Tanay2920003/HomeTank_YT/tanksync_flutter/assets/onboarding.png

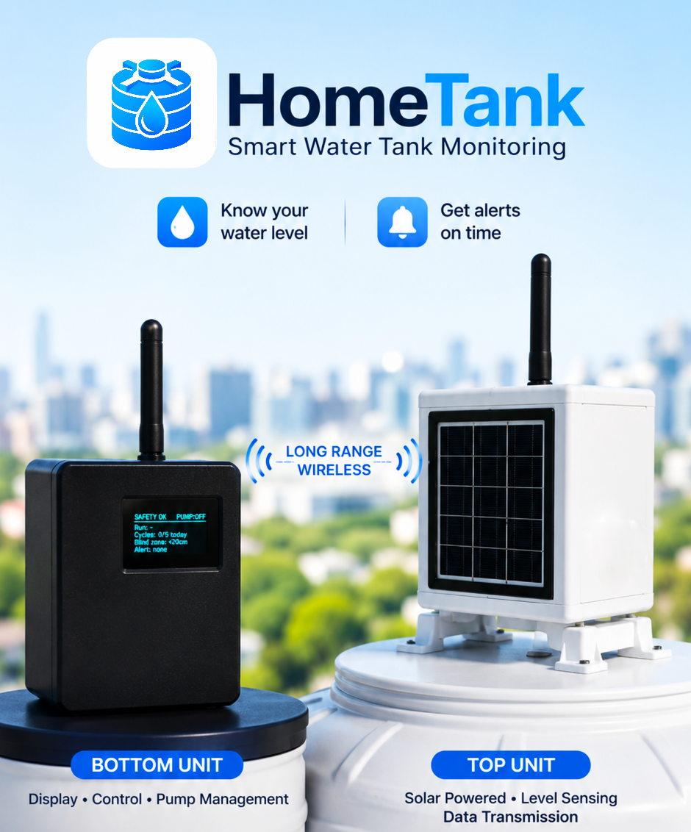
tanksync_flutter/assets/onboarding.png
