Tanay2920003/HomeTank_YT/images/img (2).png

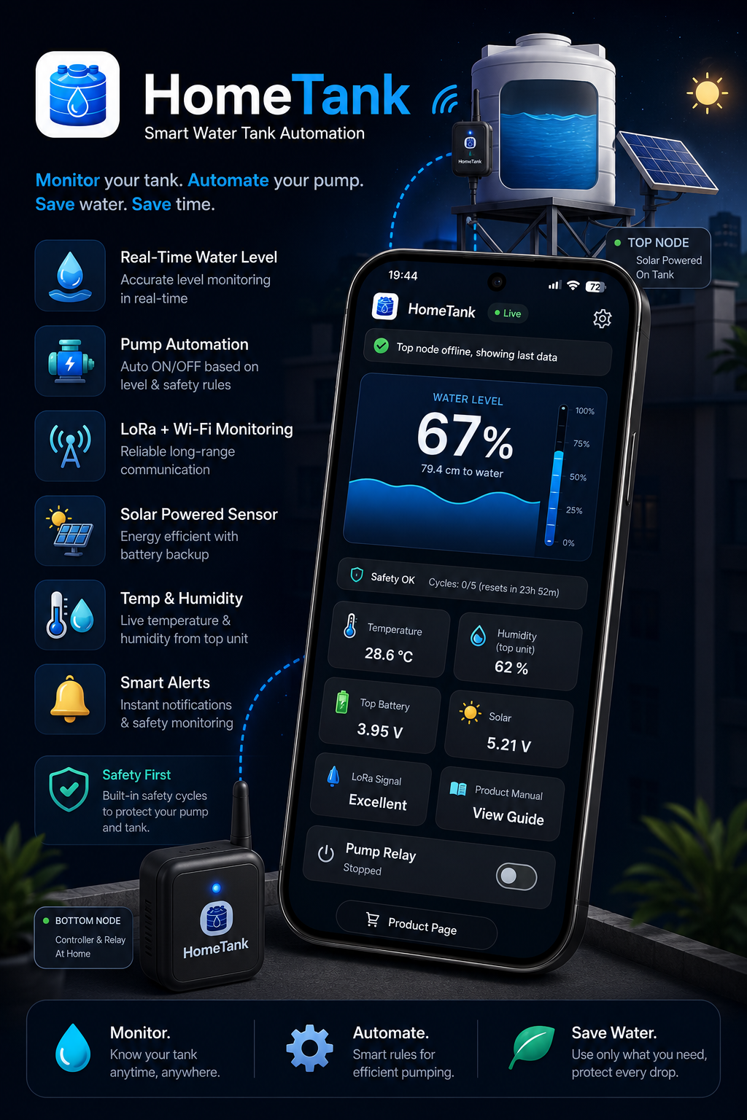
images/img (2).png
