Tanay2920003/HomeTank_YT/README.md

# HomeTank — Dual LoRa Water Tank Automation

Wireless water tank monitor and pump controller built on the **Heltec WiFi LoRa 32 V3** (SX1262).  
Two ESP32 nodes communicate over LoRa: a **Top Node** inside the tank measures water level + temperature, and a **Bottom Node** controls the pump and serves a Flutter companion app over Wi-Fi.

---

## 📸 Hardware

HomeTank top node installed on tank

Concrete roof installation

App screenshot — tank level view

PCB and enclosure

---

## 📱 App UI

<table>
  <tr>
    <td align="center">LoRa radio stats</td>
    <td align="center">Connection mode selector</td>
    <td align="center">Wi-Fi settings</td>
    <td align="center">Tank level dashboard</td>
  </tr>
</table>

---

## 🛠️ Arduino IDE Setup & Installation Guide

### 1. Board Manager Setup (Preferences)
To compile for the Heltec WiFi LoRa 32 V3 board, you must add Heltec's board package to Arduino IDE:

1. Open Arduino IDE and navigate to **File** → **Preferences** (or `Ctrl` + `,` on Windows).
2. In the **Additional Boards Manager URLs** field, paste the following URL:
   ```text
   https://resource.heltec.cn/download/package_heltec_esp32_index.json
   ```
   *(If there are already other URLs, separate them with a comma or new line).*
3. Click **OK**.
4. Navigate to **Tools** → **Board** → **Boards Manager...** (or `Ctrl` + `Shift` + `B`).
5. Search for `Heltec ESP32` and install **Heltec ESP32 Series Dev-boards**.
6. Select your board under **Tools** → **Board** → **Heltec ESP32 Series Dev-boards** → **WiFi LoRa 32(V3) / Wireless_Stick_Lite(V3)** (or **Heltec WiFi LoRa 32 (V3)**).

---

### 2. Required Libraries
Install the following required libraries via **Tools** → **Manage Libraries...** (`Ctrl` + `Shift` + `I`):

| Library Name | Author | Purpose | Used In |
| :--- | :--- | :--- | :--- |
| **RadioLib** | Jan Gromeš | SX1262 LoRa radio communication | Both Top & Bottom |
| **Heltec ESP32 Dev-Boards** | Heltec Automation | OLED Display driver (`HT_SSD1306Wire.h`) | Both Top & Bottom |
| **DHT sensor library** | Adafruit | DHT22 temperature & humidity sensor | Top Node |
| **ArduinoJson** | Benoit Blanchon | JSON serialization for web PWA API | Bottom Node |

> [!TIP]
> When installing **Heltec ESP32 Dev-Boards** or **DHT sensor library**, if Arduino IDE prompts you to install missing dependencies (such as Adafruit Unified Sensor), click **Install All**.

---

### 3. Multi-Unit Production Pairing (Unit ID System)
For production deployments where multiple tank systems operate within LoRa radio range, a hardcoded pairing system prevents RF cross-talk:

- In both `top code/top/final/final/final.ino` and `bottomfinal/sketch_apr1h/final/final/final.ino`, locate the configuration definition:
  ```cpp
  #define UNIT_ID 1001
  ```
- **Important**: Both the Top node and Bottom node for a single tank system **must** share the exact same `UNIT_ID`.
- When manufacturing or installing Unit 2, change `#define UNIT_ID 1002` in both files before flashing. For Unit 3, use `1003`, and so on (supported range: `1` to `65535`).
