Tanay2920003/HomeTank_YT/images/img (1).jpg

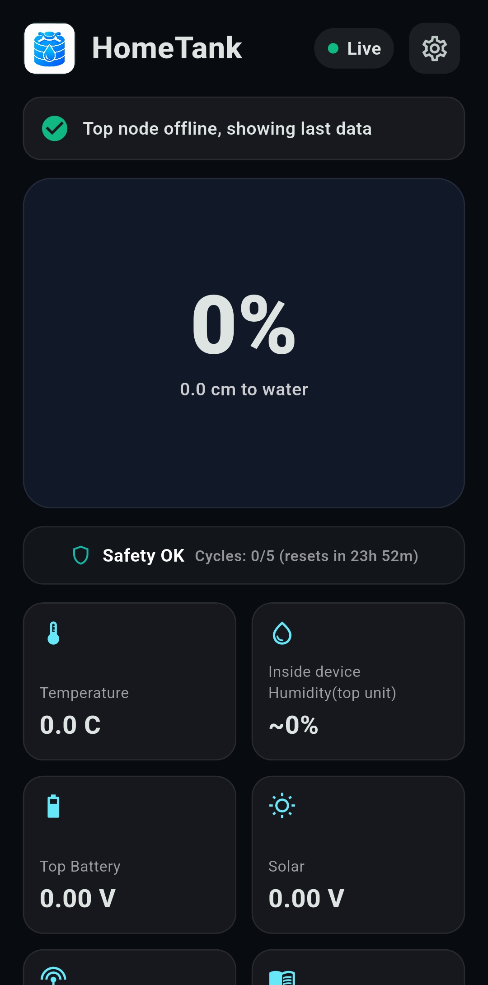
images/img (1).jpg
