Tanay2920003/HomeTank_YT/images/img (1).png

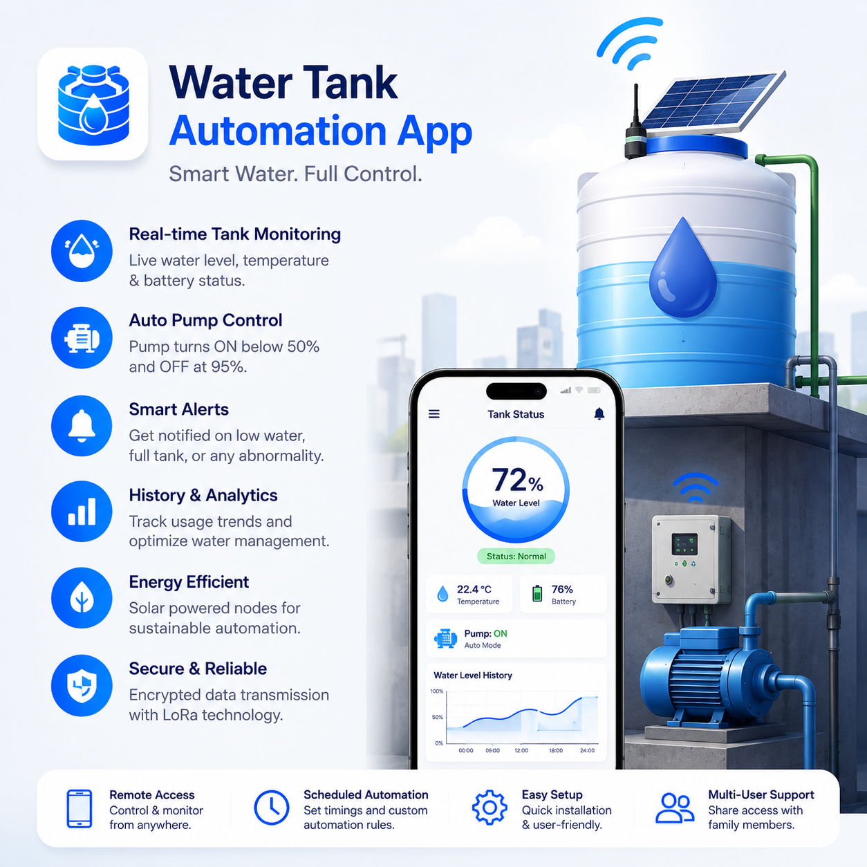
images/img (1).png
