Tanay2920003/HomeTank_YT/images/img (2).jpg

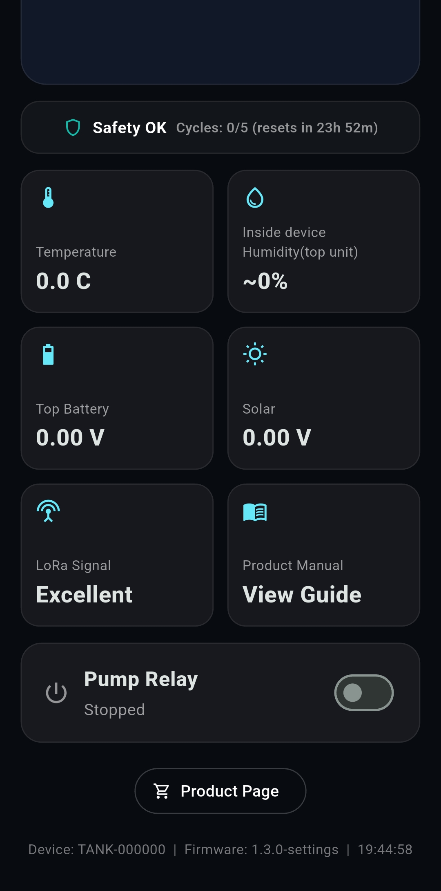
images/img (2).jpg
