Tanay2920003/HomeTank_YT/3D printed/main-body.stl

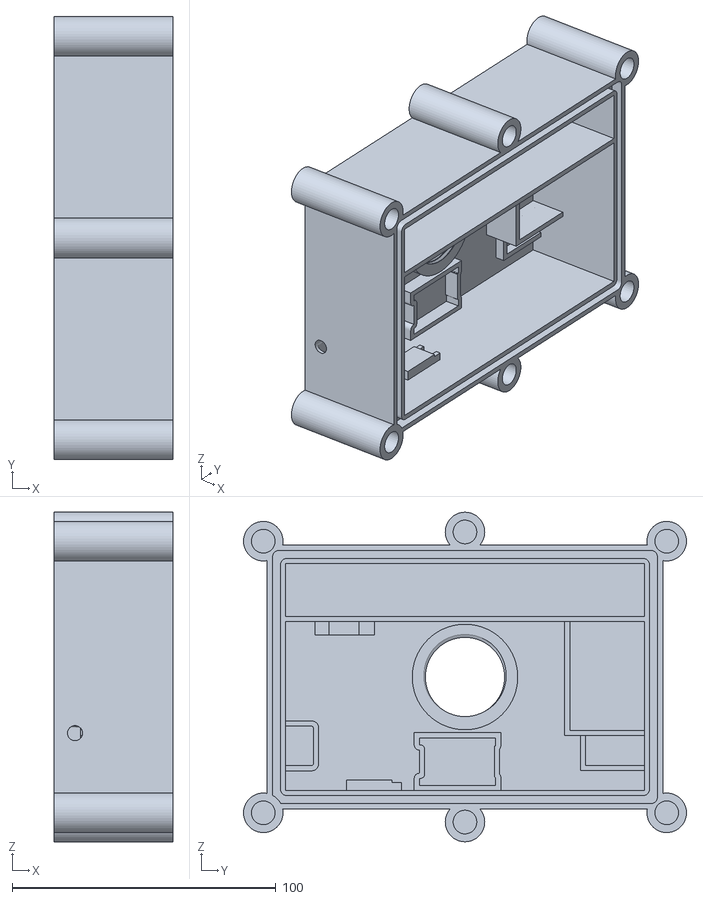
[picture p7: CAD file, 2026-10-11]
3D printed/main-body.stl
45.0 x 168.0 x 125.0
