Tanay2920003/HomeTank_YT/3D printed/top-lid.stl

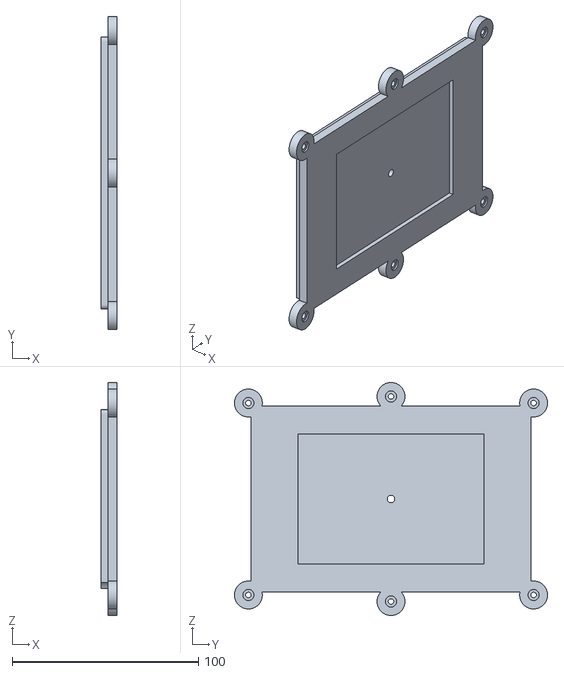
[picture p8: CAD file, 2026-10-11]
3D printed/top-lid.stl
8.75 x 168.0 x 125.0
