Tanay2920003/HomeTank_YT/3D printed/tpu-gasket.stl

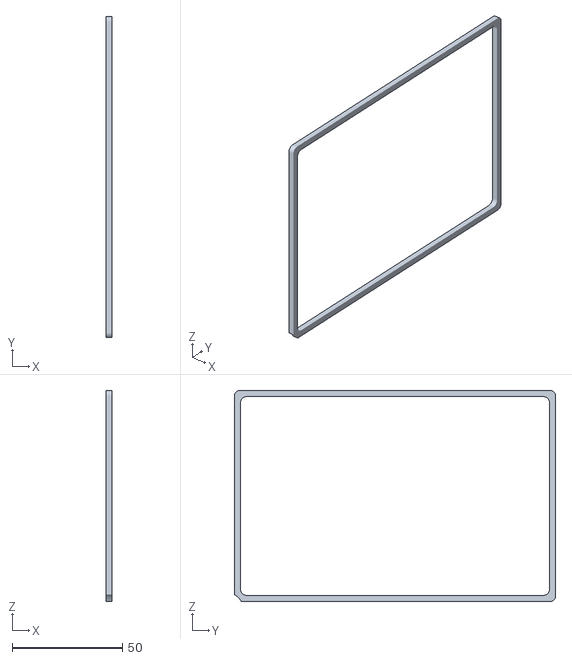
[picture p9: CAD file, 2026-10-11]
3D printed/tpu-gasket.stl
2.50 x 145.8 x 95.8
