Tanay2920003/HomeTank_YT/3D printed/nut.stl

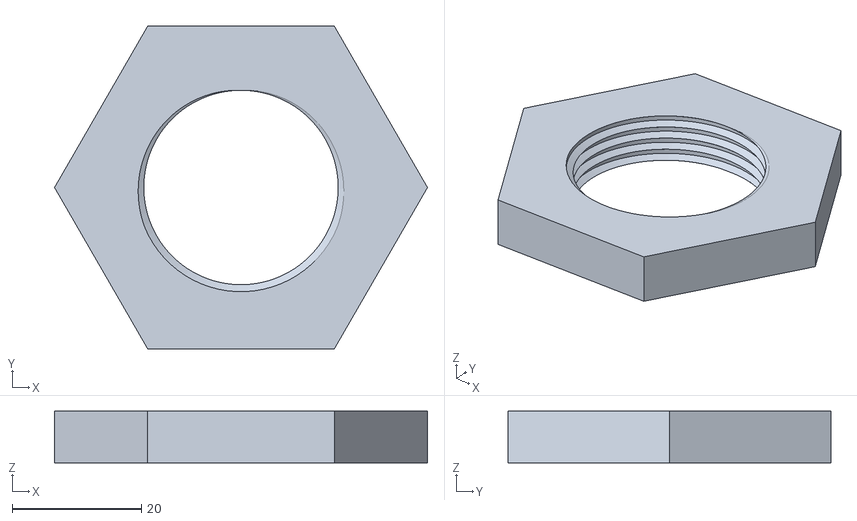
[picture p10: CAD file, 2026-10-11]
3D printed/nut.stl
57.7 x 50.0 x 8.03
