Tanay2920003/HomeTank_YT/3D printed/bolt-screw.3mf

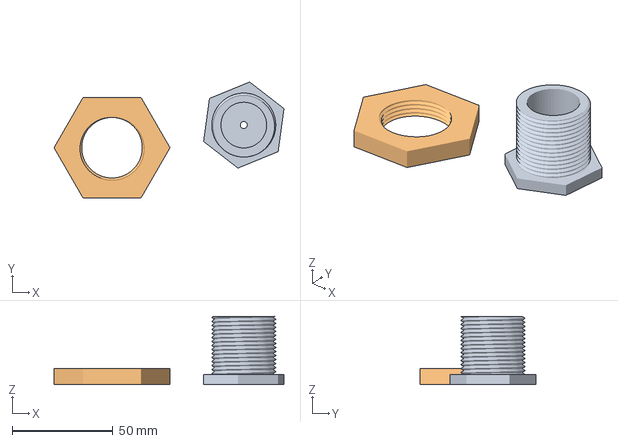
[picture p11: CAD file, 2026-10-11]
3D printed/bolt-screw.3mf
114.4 x 57.7 x 34.0 mm
sensor-screw.stl
nut.stl
