Tanay2920003/HomeTank_YT/3D printed/sensor-screw.stl

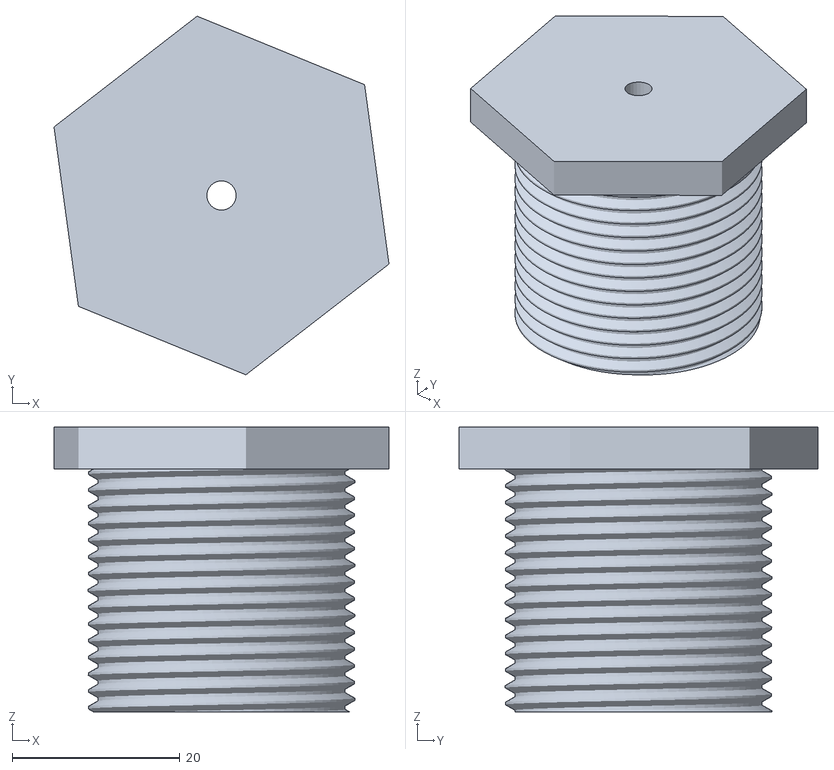
[picture p12: CAD file, 2026-10-11]
3D printed/sensor-screw.stl
40.0 x 42.8 x 34.0
